IDE-GID-Cyberphysical-Systems/de-arm/wiki-images/claw-smaller.jpg

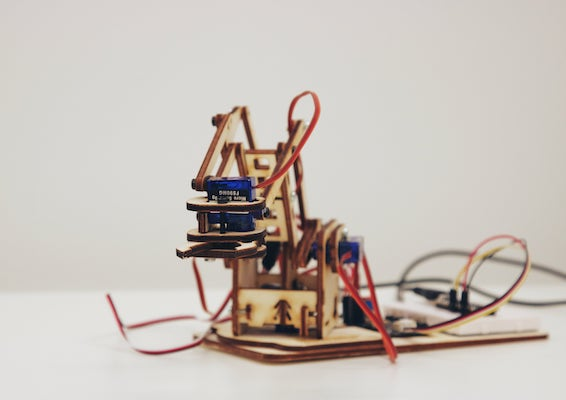
wiki-images/claw-smaller.jpg
