IDE-GID-Cyberphysical-Systems/de-arm/physical-build-resources/DE-Arm-BoM.xlsx

DE Arm 25 Bill of Materials
Part Name | Quantity | Material Name
DE Arm 25 4mm Parts | 31 | 4mm PlyWood
DE Arm 25 2mm Parts | 3 | 2.5mm MDF
M3 x 0.5 x 6 Screw | 2 | Steel
M3 x 0.5 x 8 Screw | 10 | Steel
M3 x 0.5 x 12 Screw | 13 | Steel
M3 x 0.5 x 20 Screw | 2 | Steel
SG90 - Micro Servo 9g | 4 | Plastic
Stick-on Feet | 4 | Silicon
