IDE-GID-Cyberphysical-Systems/de-arm/physical-build-resources/DE-Arm-2mm.dxf

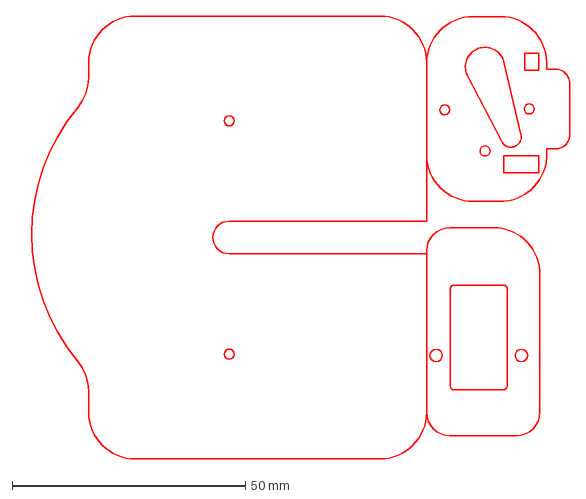
[picture p4: CAD file, 2025-09-08]
physical-build-resources/DE-Arm-2mm.dxf
118.7 x 95.0 mm
