IDE-GID-Cyberphysical-Systems/de-arm/physical-build-resources/DE-Arm-4mm.dxf

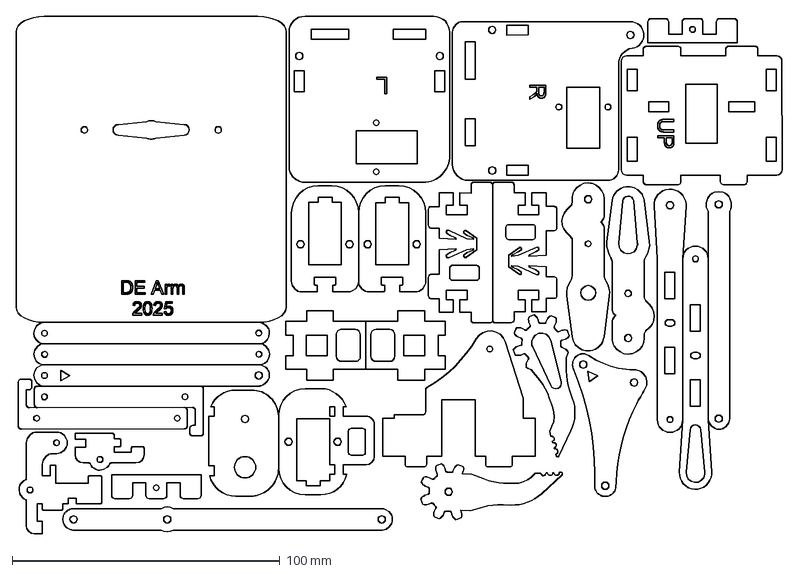
[picture p5: CAD file, 2025-09-08]
physical-build-resources/DE-Arm-4mm.dxf
286.0 x 193.2 mm
