IDE-GID-Cyberphysical-Systems/de-arm/physical-build-resources/DE-Arm-Assembly.pdf

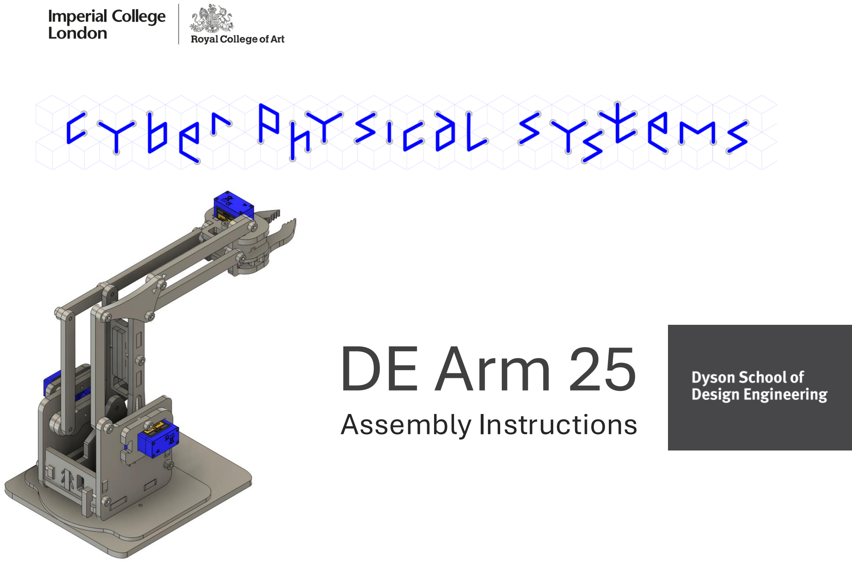
[picture p6: page 1]

# DE Arm 25

Assembly Instructions

# Important Notes:

- Joints should move freely, do not overtighten the screws. The arm should be like a marionette without the servo motors.
- Before assembly you have to test and calibrate your servo motors to the positions shown in page 5.
- Take it easy, parts should sit in place with little force, if you find yourself using excessive force, check the manual and orientation again.

# List of Parts

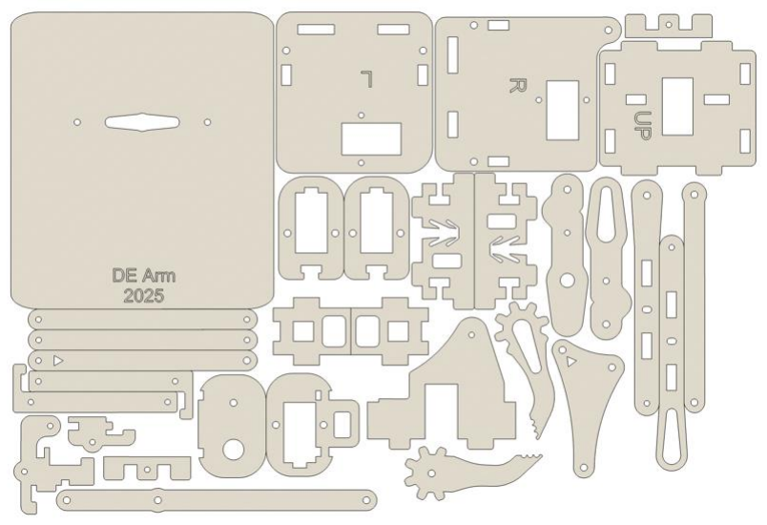
[picture p7: figure]

- 4mm Plywood Parts: 31 pcs

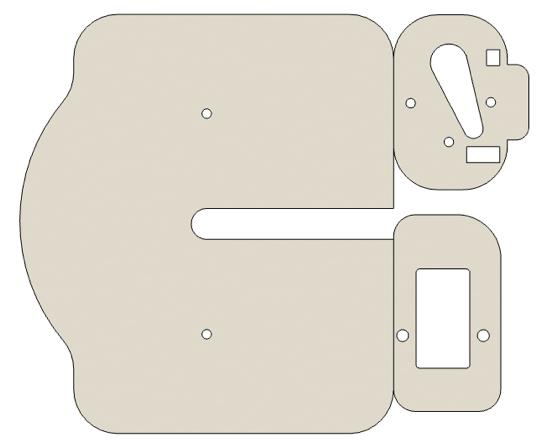
[picture p8: figure]

- 2.5mm MDF Parts: 3 pcs

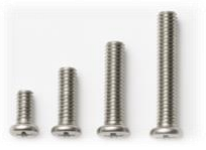
[picture p9: figure]

# List of Parts

- M3 x 6mm Screw: 2 pcs
- M3 x 8mm Screw: 10 pcs
- M3 x 12mm Screw: 13 pcs
- M3 x 20mm Screw: 2 pcs

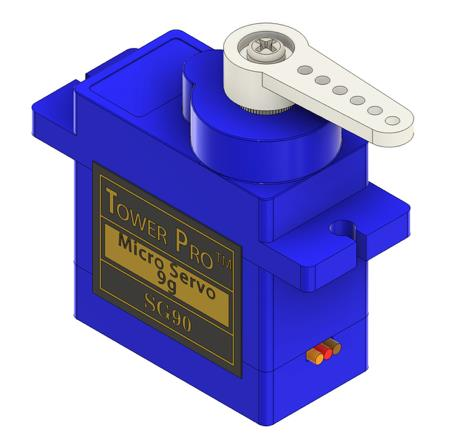
[picture p10: figure]

- SG90 Servo Motor: 4 pcs

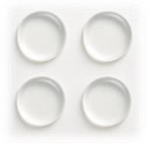
[picture p11: figure]

- Stick-on Silicon Feet: 4 pcs

# Servo Calibration

*You should have a total of 4 servos, calibrated as followed, They will be identified and used in the assembly.

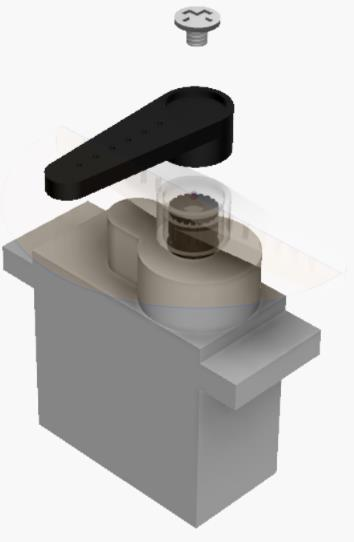
[picture p12: figure]
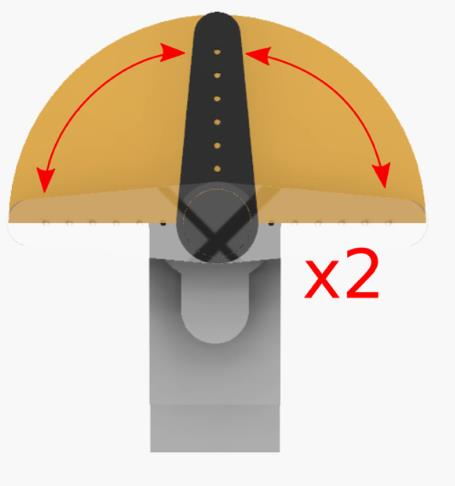
[picture p13: figure]
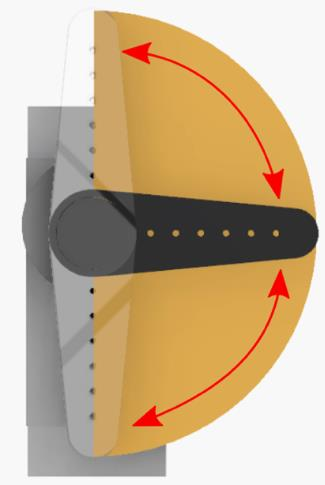
[picture p14: figure]
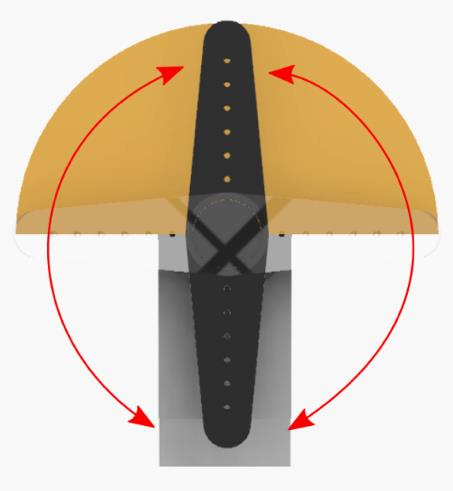
[picture p15: figure]
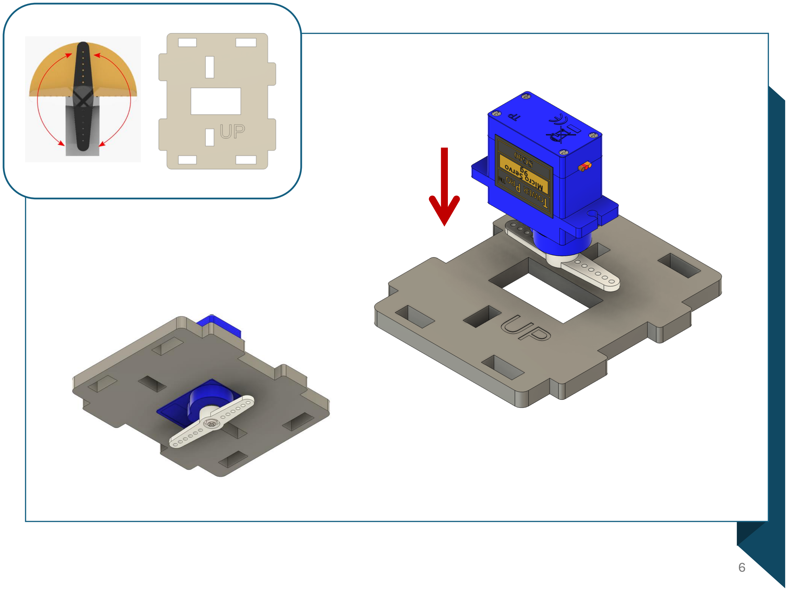
[picture p16: page 6]
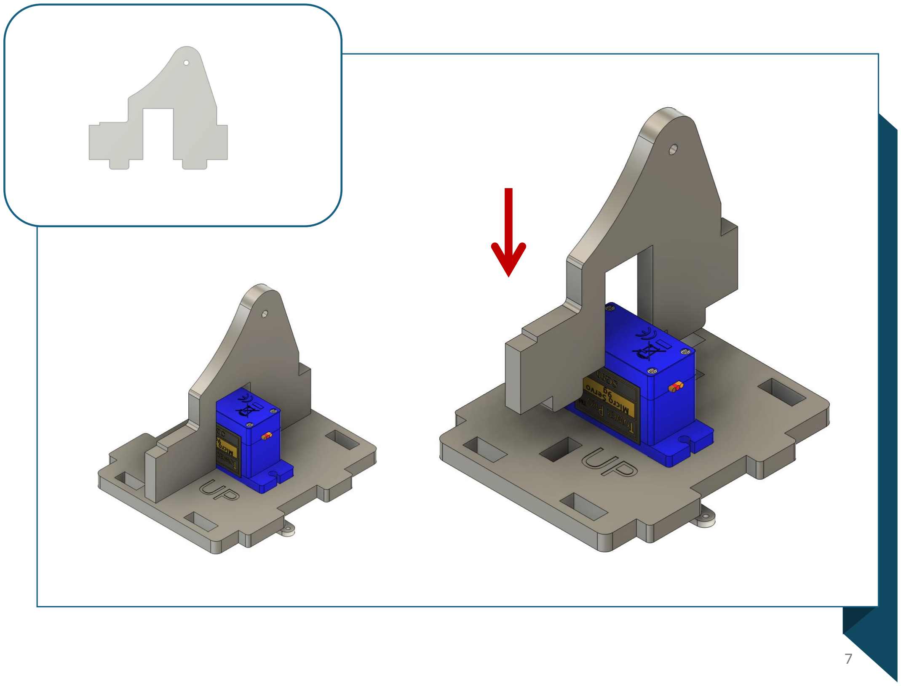
[picture p17: page 7]
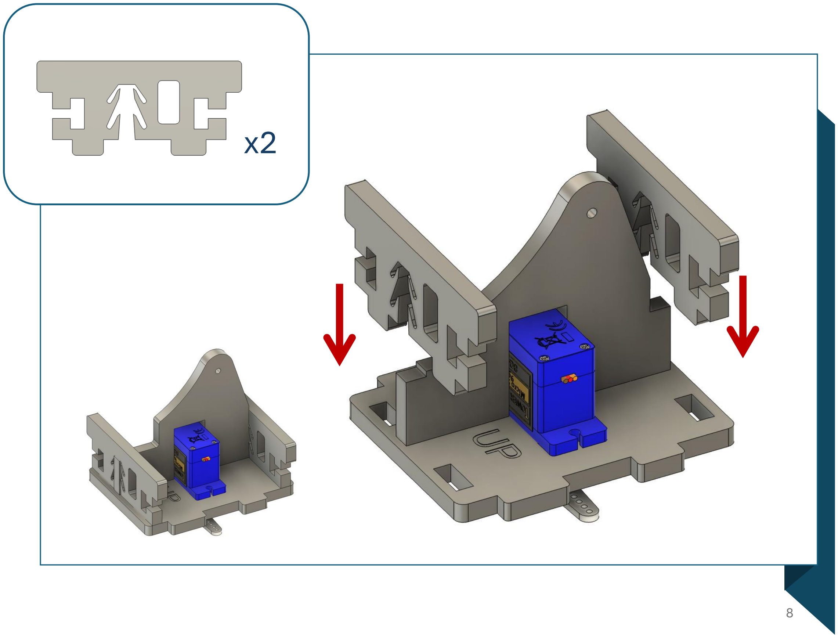
[picture p18: page 8]

x2

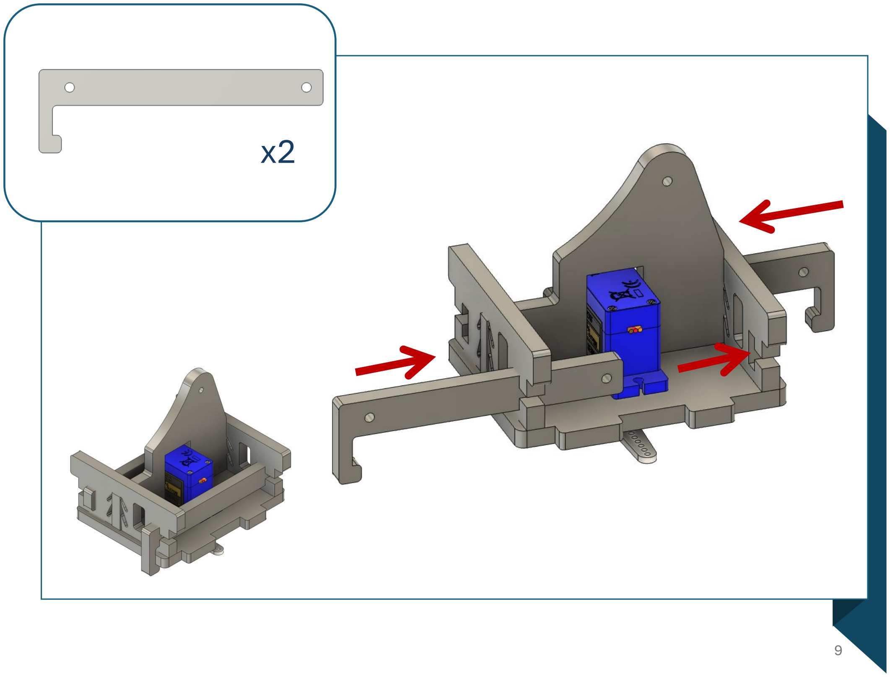
[picture p19: page 9]

x2

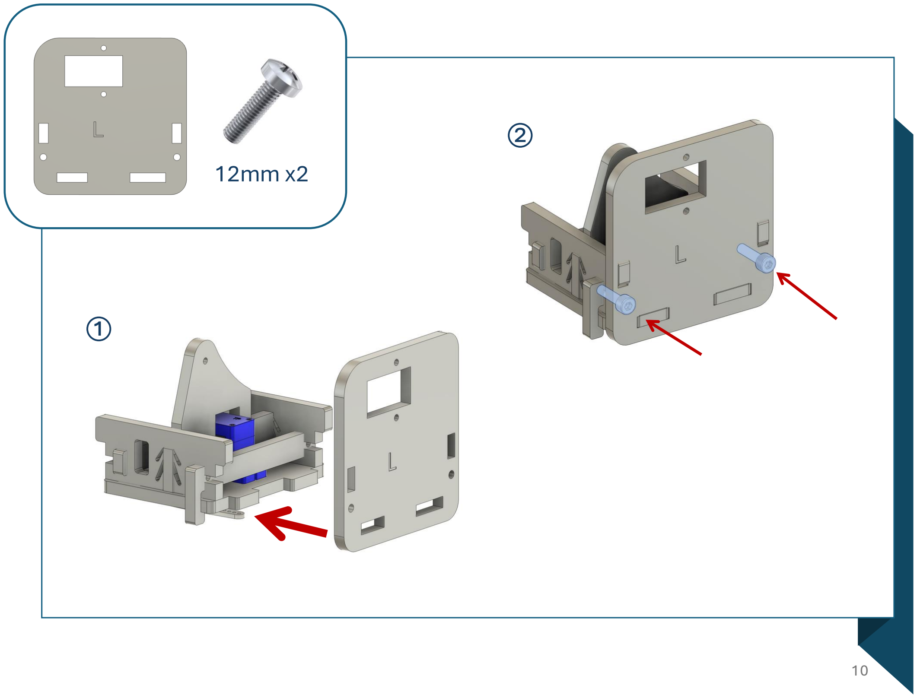
[picture p20: page 10]

12mm x2

②

①

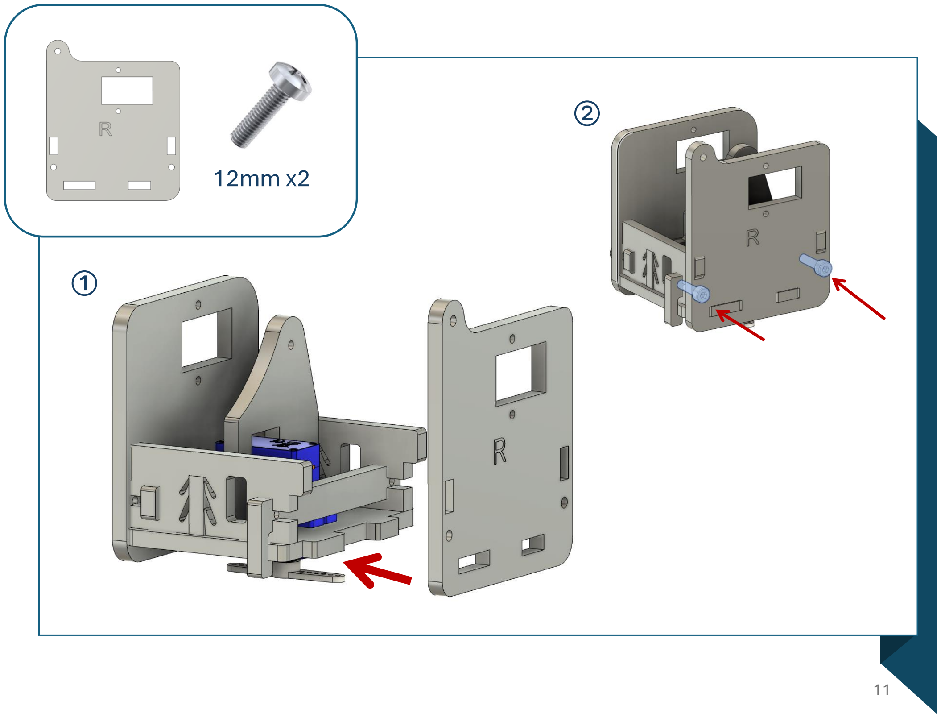
[picture p21: page 11]

12mm x2

①

②

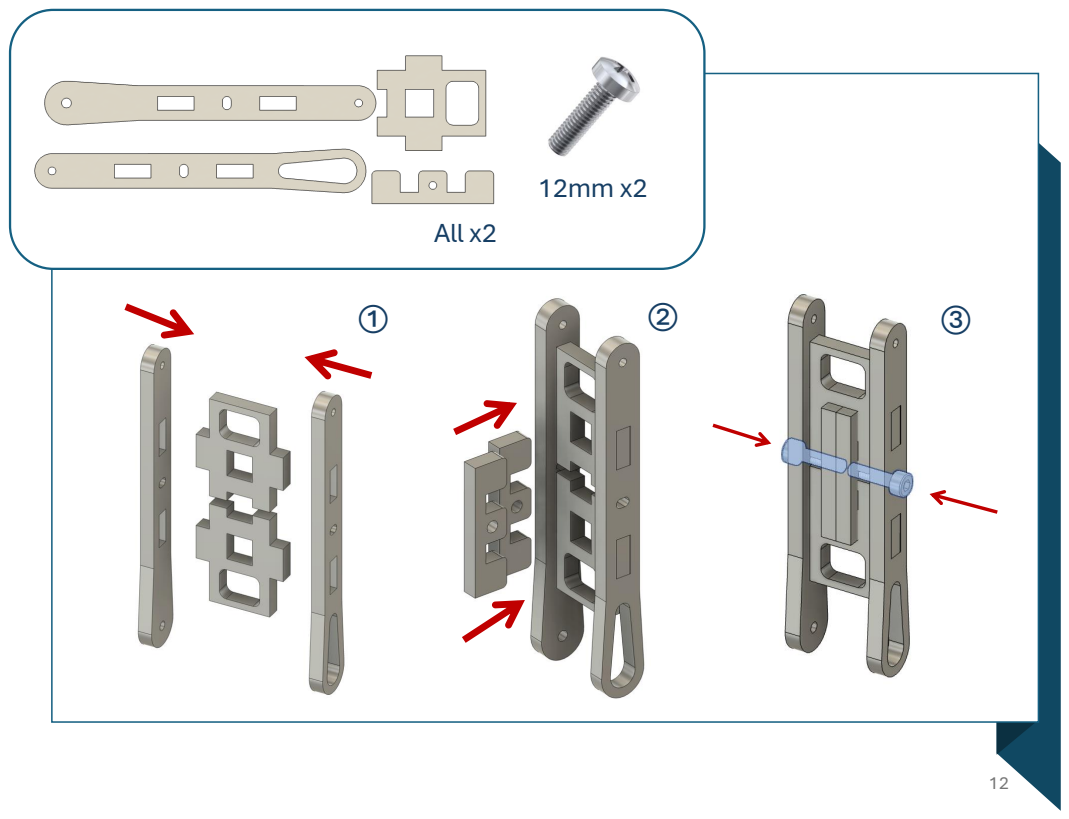
[picture p22: page 12]
All x2

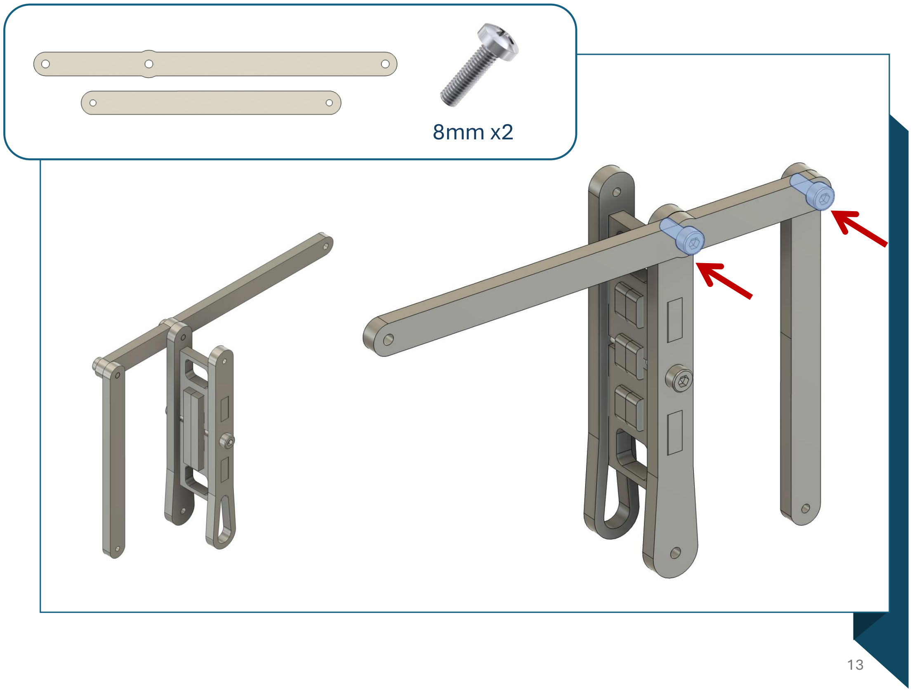
[picture p23: page 13]

8mm x2

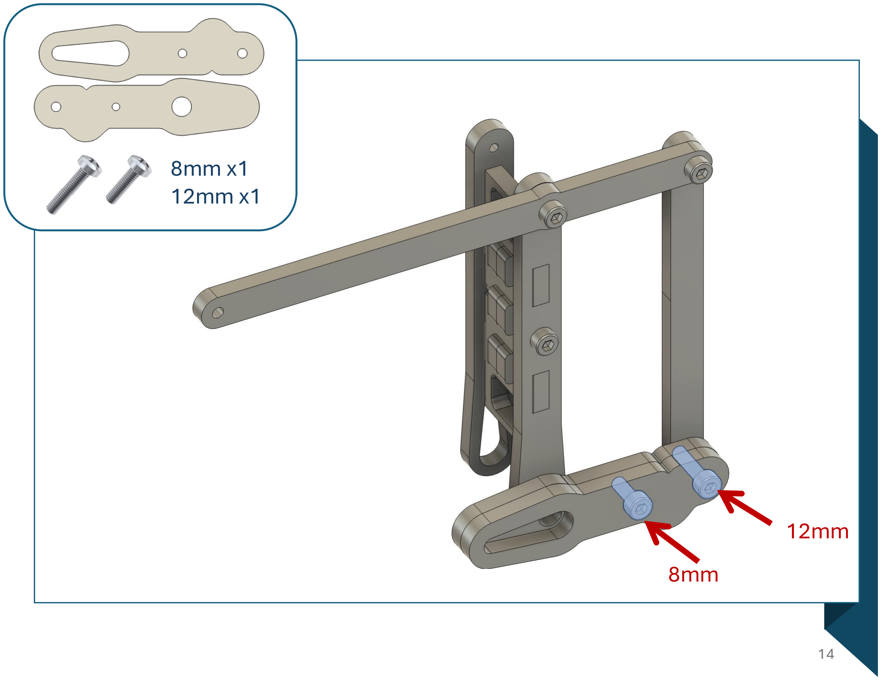
[picture p24: page 14]

8mm x1
12mm x1

8mm

12mm

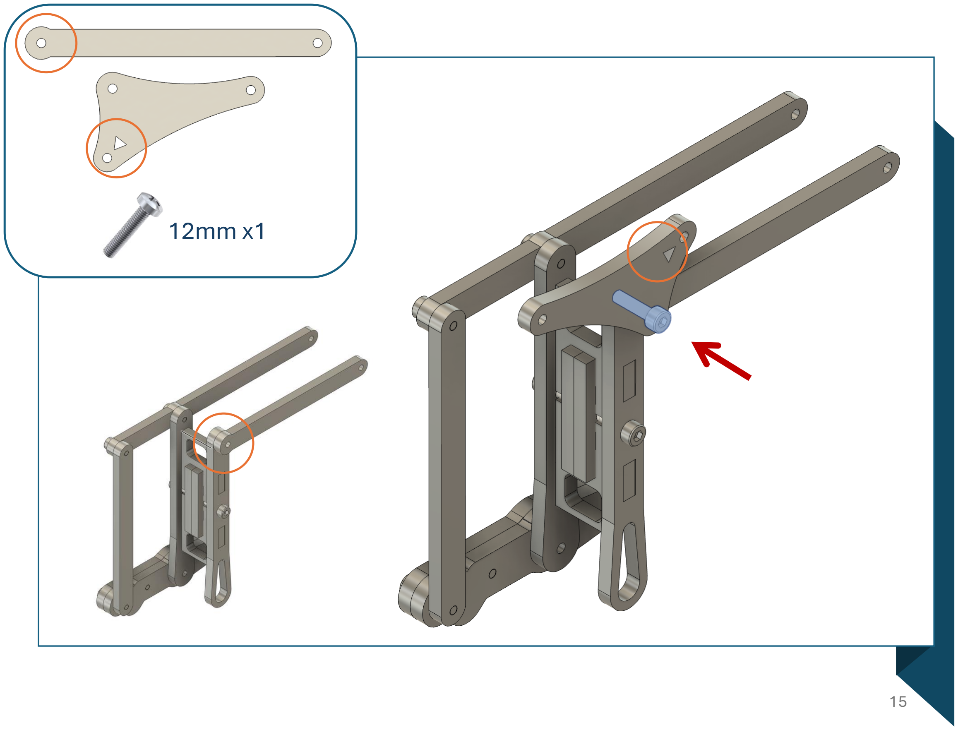
[picture p25: page 15]

12mm x1

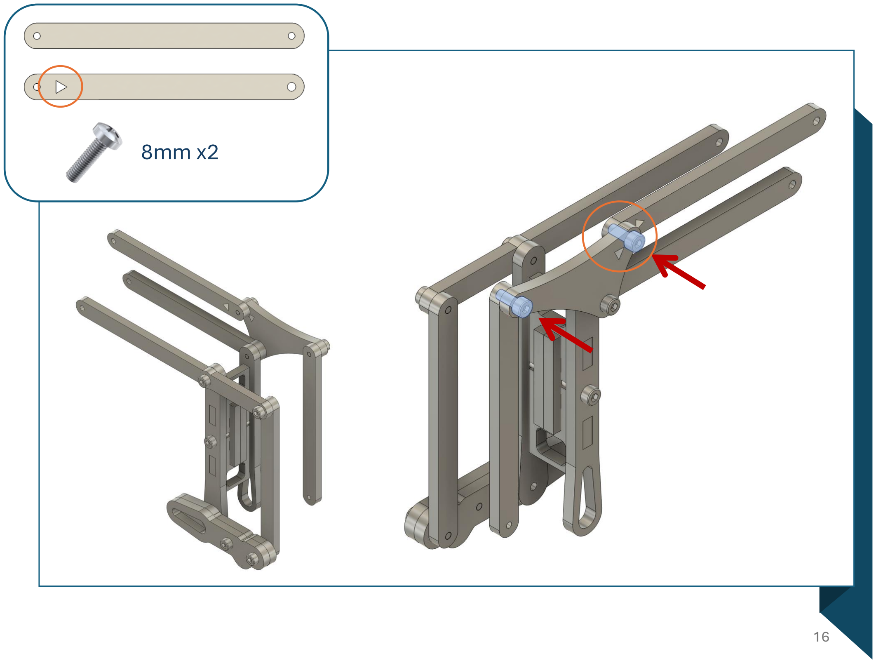
[picture p26: page 16]

8mm x2

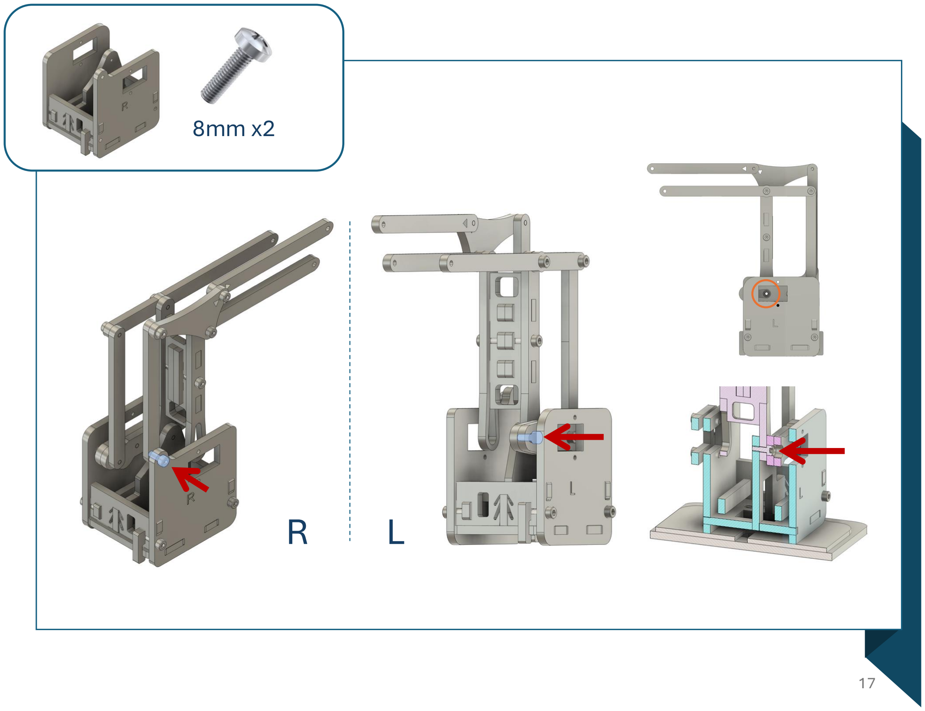
[picture p27: page 17]

8mm x2

R L

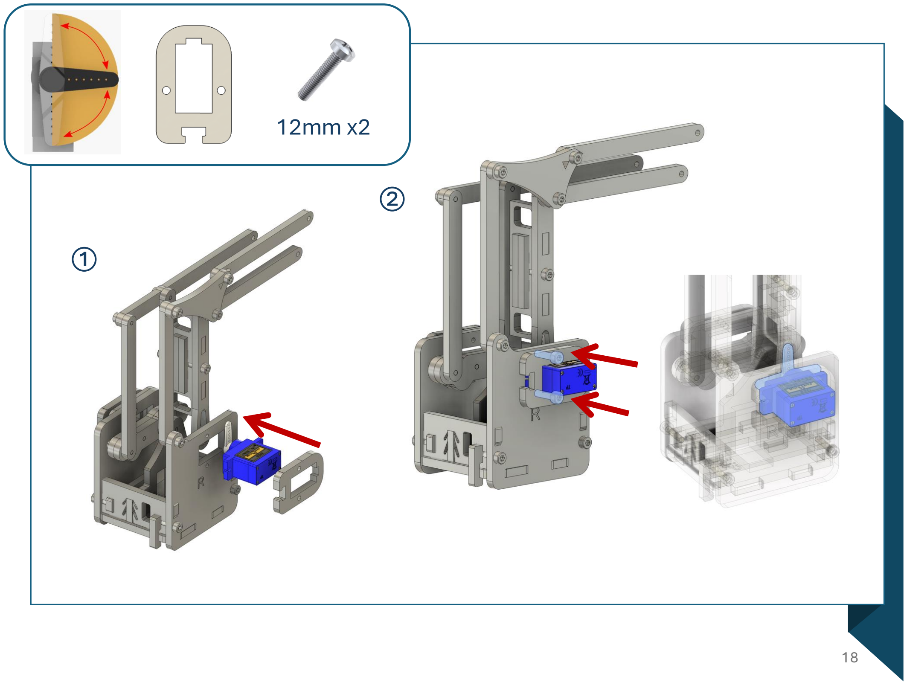
[picture p28: page 18]

12mm x2

①

②

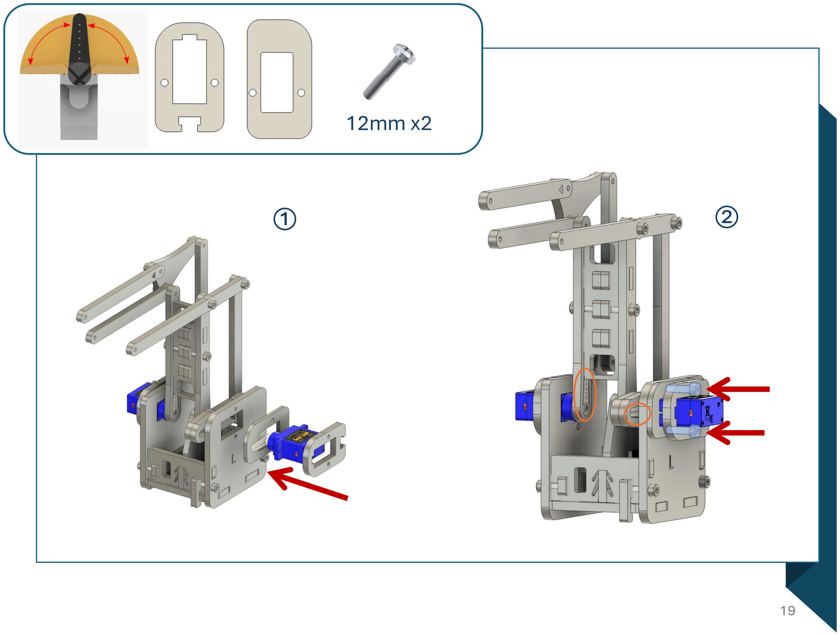
[picture p29: page 19]

12mm x2

① | ②

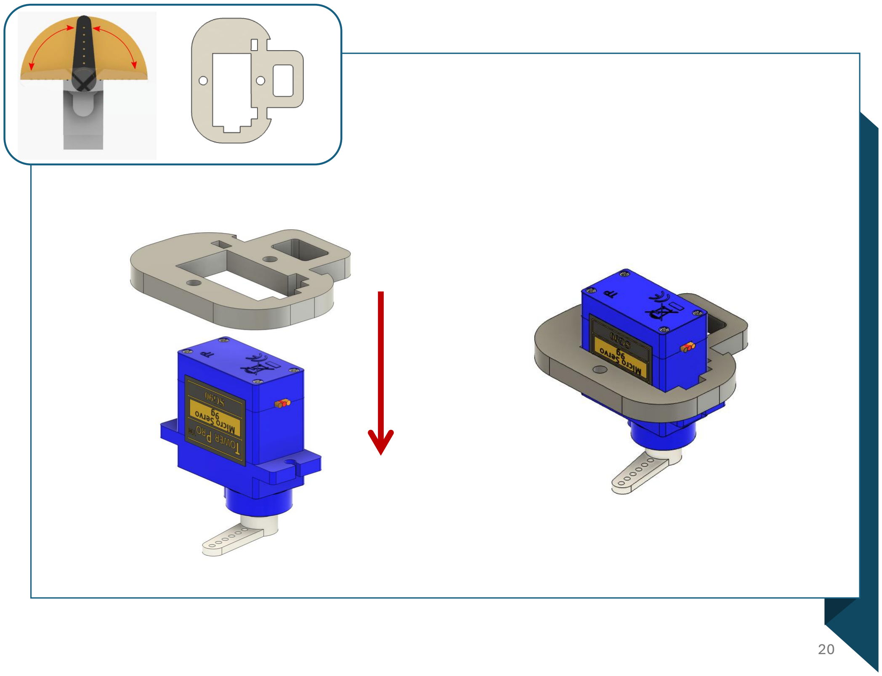
[picture p30: page 20]
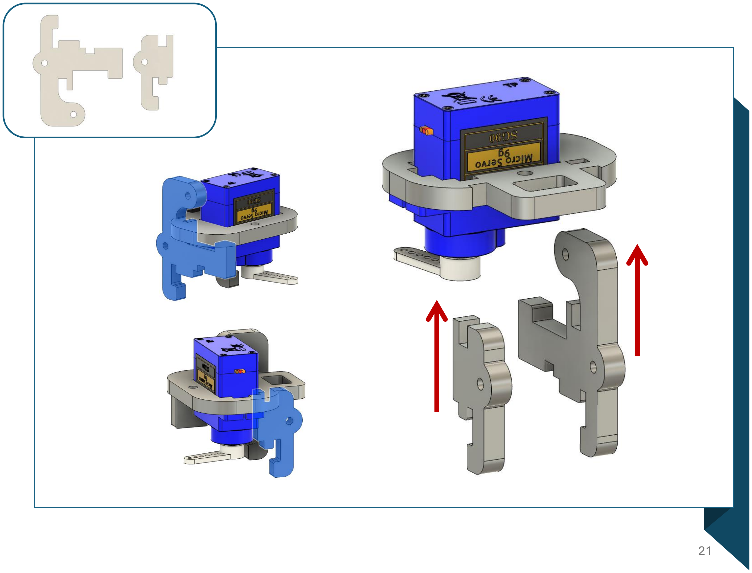
[picture p31: page 21]
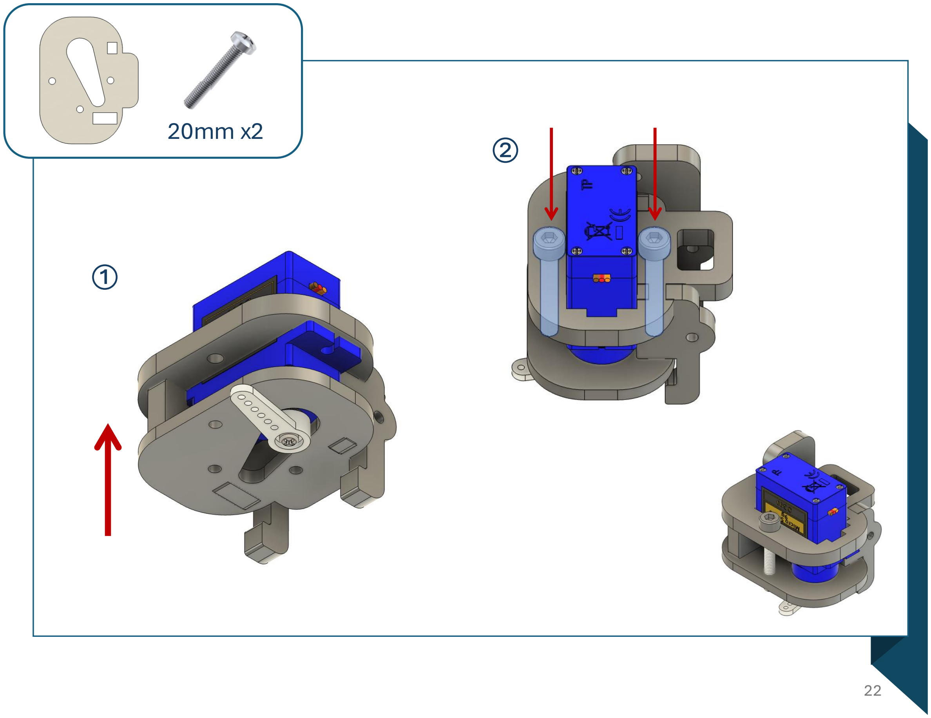
[picture p32: page 22]

20mm x2

①

②

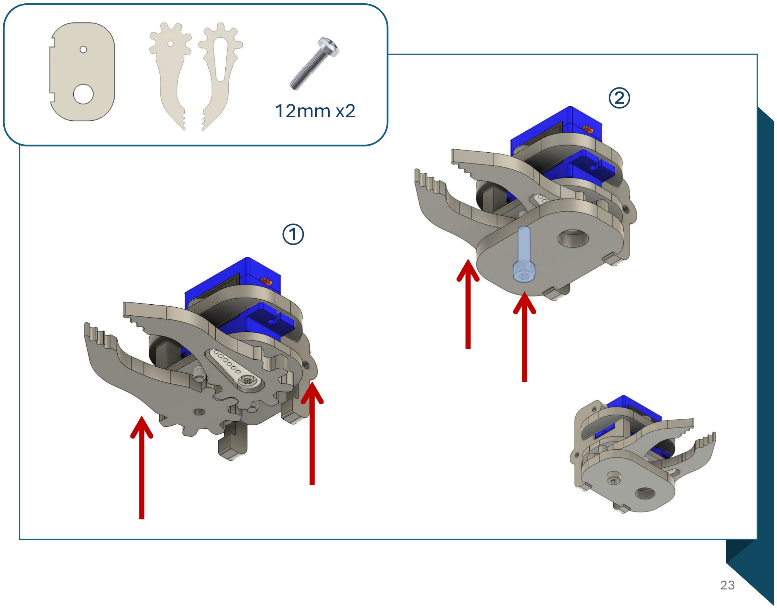
[picture p33: page 23]

①

12mm x2 | ②

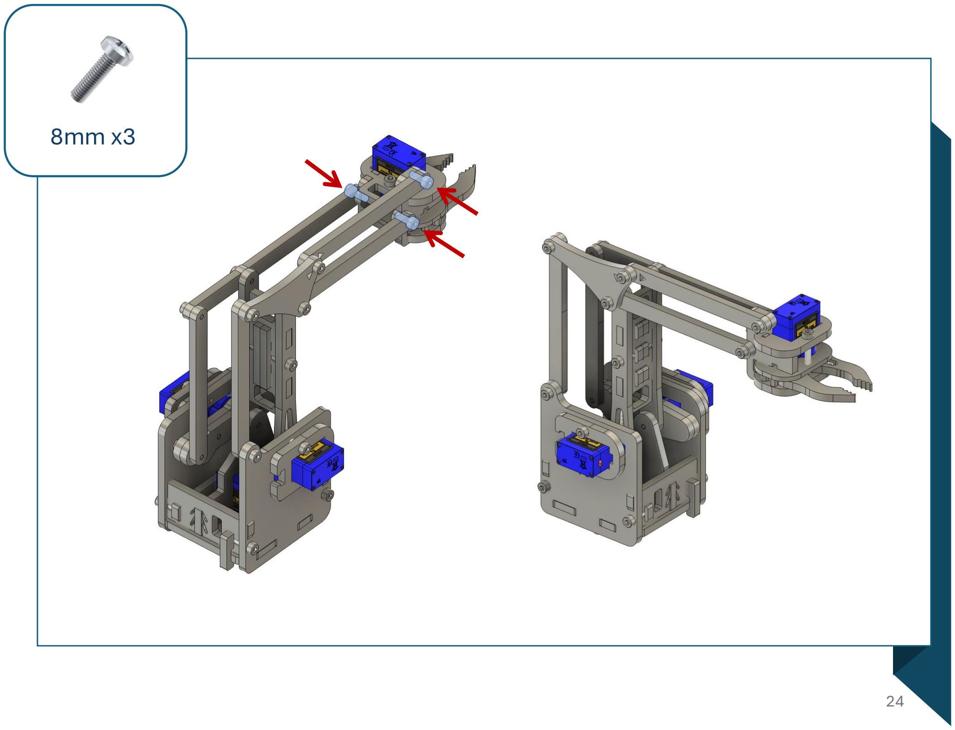
[picture p34: page 24]

8mm x3

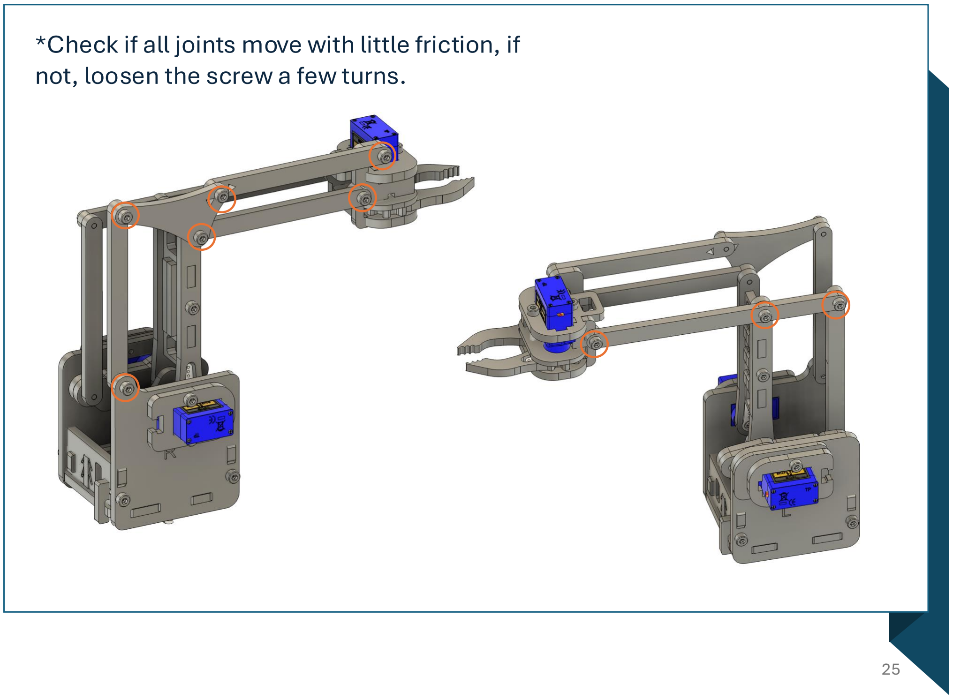
[picture p35: figure]
not, loosen the screw a few turns.

*Check if all joints move with little friction, if

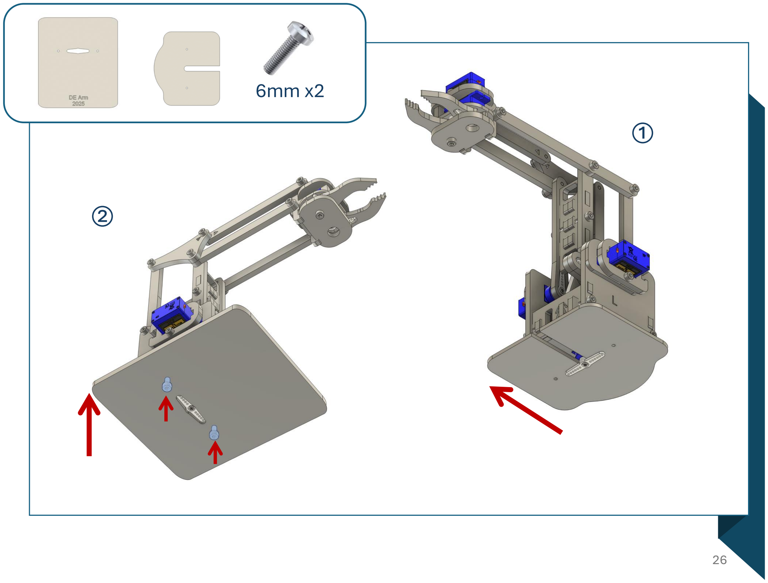
[picture p36: page 26]

6mm x2
①

②

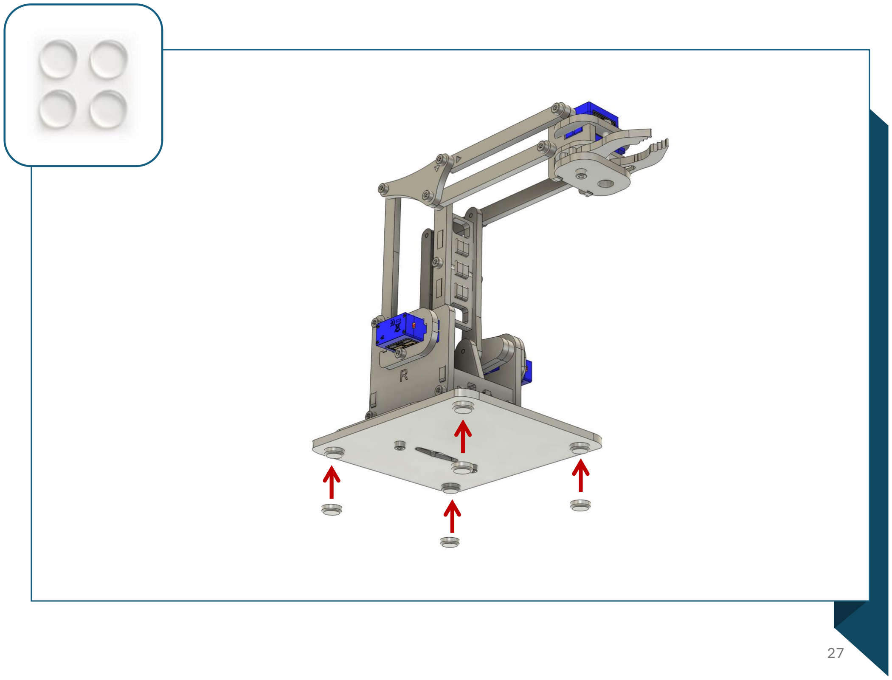
[picture p37: page 27]
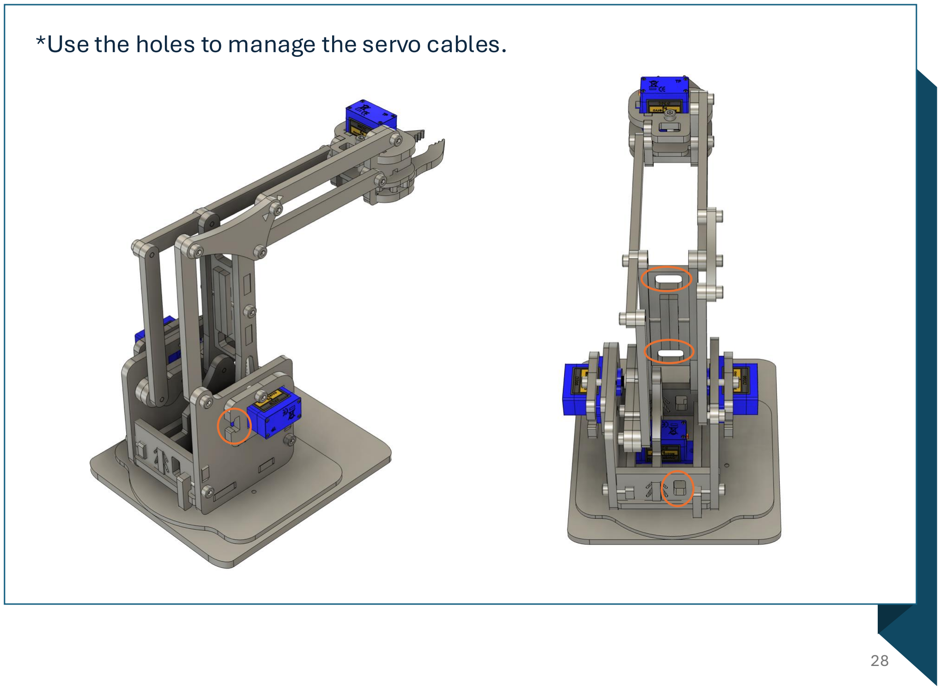
[picture p38: page 28]

*Use the holes to manage the servo cables.

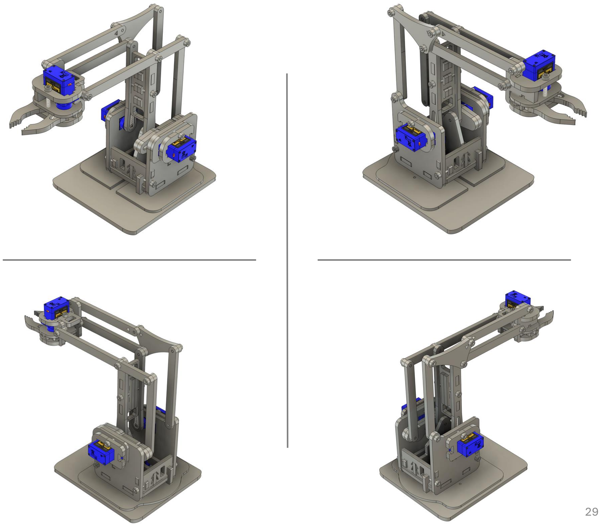
[picture p39: page 29]
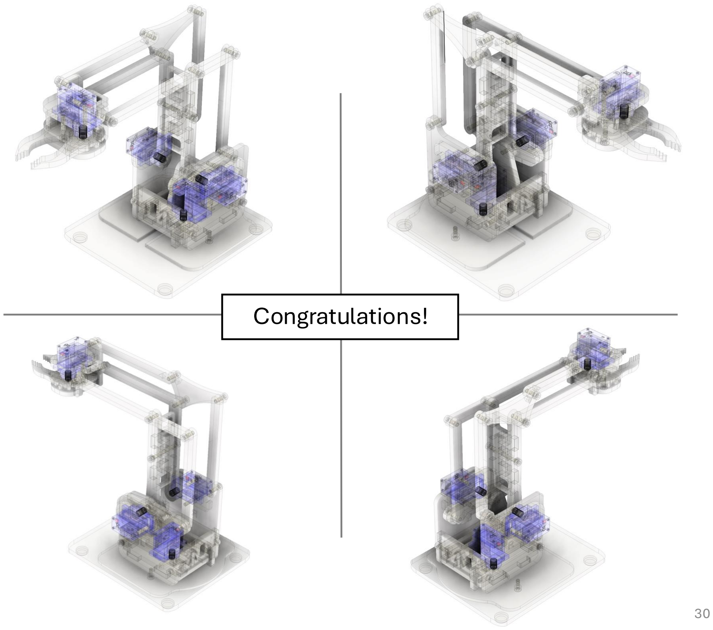
[picture p40: page 30]

Congratulations!

Development Notes:

The DE-Arm is remastered by Tong Zhang and Dr Rebecca Stewart, from the open source MeArm V3 from [MeArm Robotics (https://mearm.com/) Lab]. (https://mearm.com/)

The original build instructions for the MeArm can be found on the [company website] (http://learn.mearm.com/docs/building-the-mearm-v3) and [Instructables].The (https://www.instructables.com/MeArm-Build-a-Small-Hackable-Robot-Arm) original laser cutting file that was modified to create the DE-Arm is available on [Thingiverse]. (https://www.thingiverse.com/thing:3420797)

This module is taught at the [Dyson School of Design Engineering] (https://www.imperial.ac.uk/design-engineering) at [Imperial College London]. (https://www.imperial.ac.uk/)
