IDE-GID-Cyberphysical-Systems/de-arm/(commit log)

2024-10-08 Updated arm laser cutting files
    [DE-Arm2022.dxf]
2024-10-08 Removed motor shield from system diagram
2024-10-16 Updated base plate files
2025-09-08 DE 25 Preliminary Commit
    [2025Arm2.5mm.dxf, 2025Arm4mm.dxf, DE Arm 25 BoM.xlsx]
2025-09-08 New DE Arm 25 directory
    [2025Arm2.5mm.dxf]
2025-09-08 DE Arm 25 Housekeeping
    [2025Arm4mm.dxf, DE Arm 25 BoM.xlsx, DE-Arm-BOM.xlsx]
2025-09-08 Instructions V0 complete
    [DE Arm 25 BoM.xlsx]
2025-09-08 Improved graphics design for the manual, improved file structure, updated file names, updated README.md
    [2025Arm2.5mm.dxf, 2025Arm4mm.dxf, DE Arm 25 BoM.xlsx, DE-Arm-2.5mm.dxf, DE-Arm-4mm.dxf, DE-Arm-BOM.xlsx, DE-Arm-BoM.xlsx]
2025-09-28 Replaced 2.5mm MDF with 2mm
2026-10-08 Removed 2024 version
    [DE-Arm-BOM.xlsx]
